DitroniX/IPEM-Plus-ESP32-C5-LoRa-LoRaWAN-IoT-Mains-Power-Energy-Monitor/Certification/ESP32-C5-WROOM-1 SRRC Certification.pdf

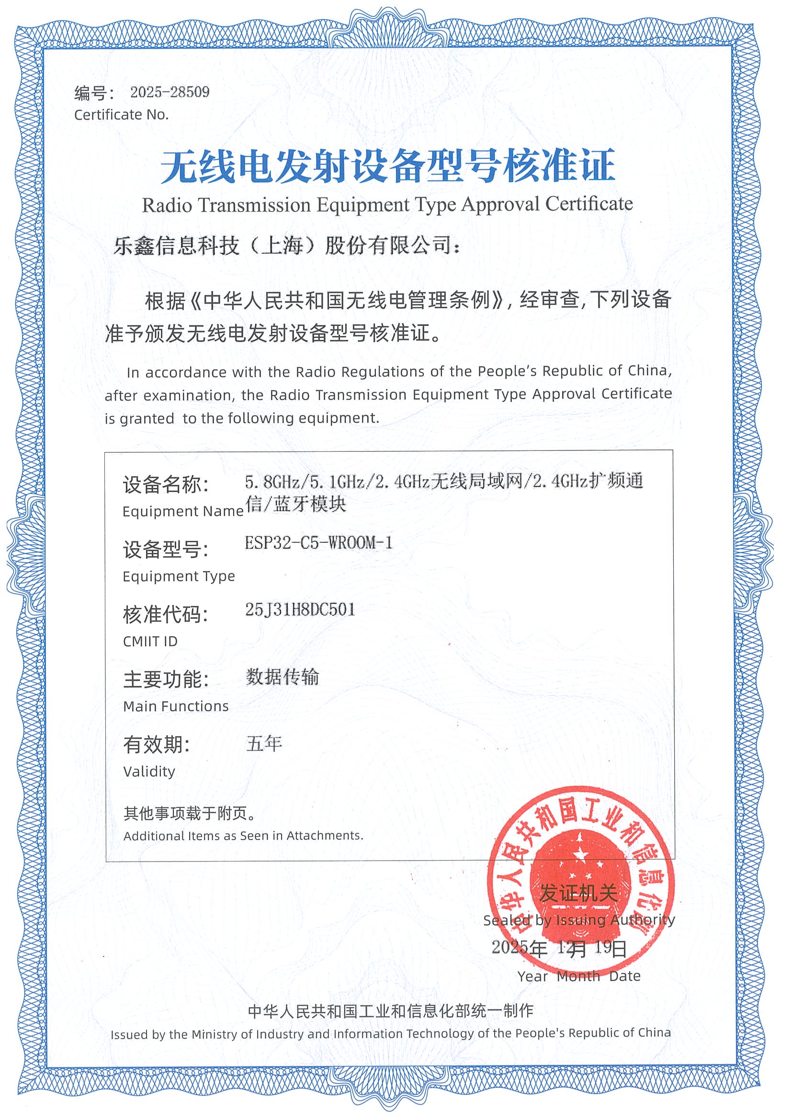
[picture p7: page 1]
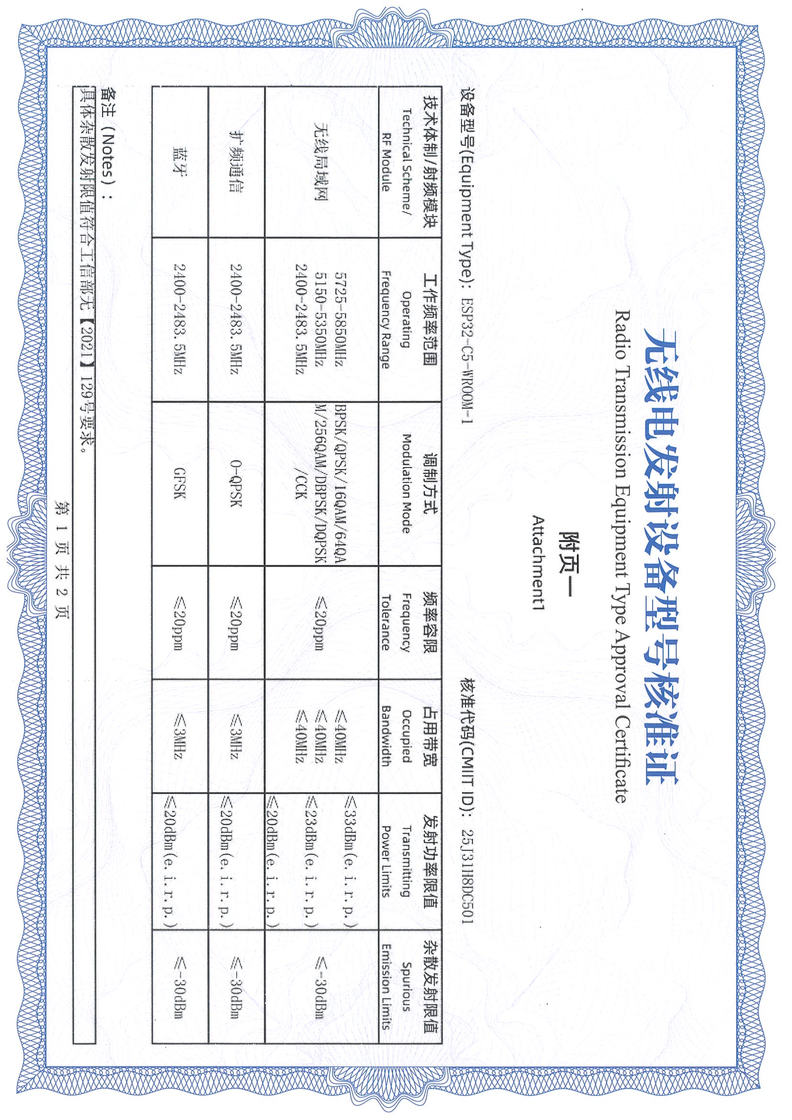
[picture p8: page 2]
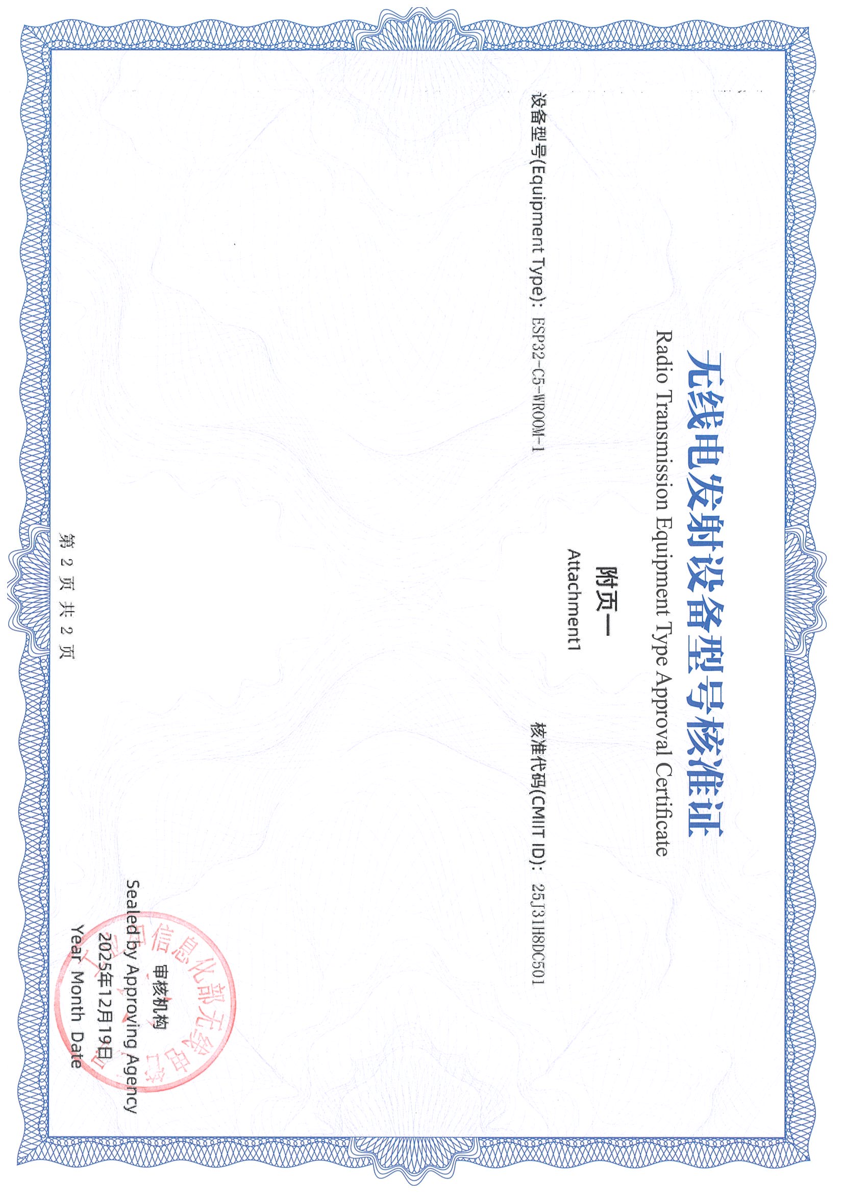
[picture p9: page 3]
