DitroniX/IPEM-Plus-ESP32-C5-LoRa-LoRaWAN-IoT-Mains-Power-Energy-Monitor/Datasheets and Information/Arduino ESP32C5 Dev Selection.png

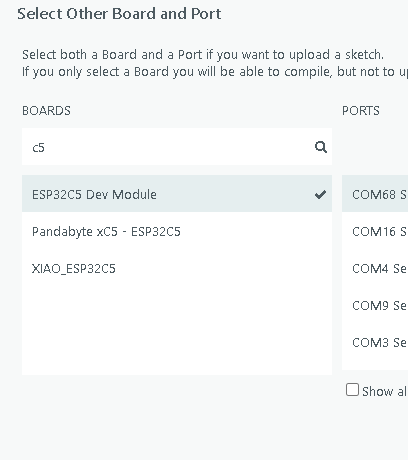
Datasheets and Information/Arduino ESP32C5 Dev Selection.png
