DitroniX/IPEM-Plus-ESP32-C5-LoRa-LoRaWAN-IoT-Mains-Power-Energy-Monitor/Datasheets and Information/Arduino IDE ESP32-C5 Board and Port.png

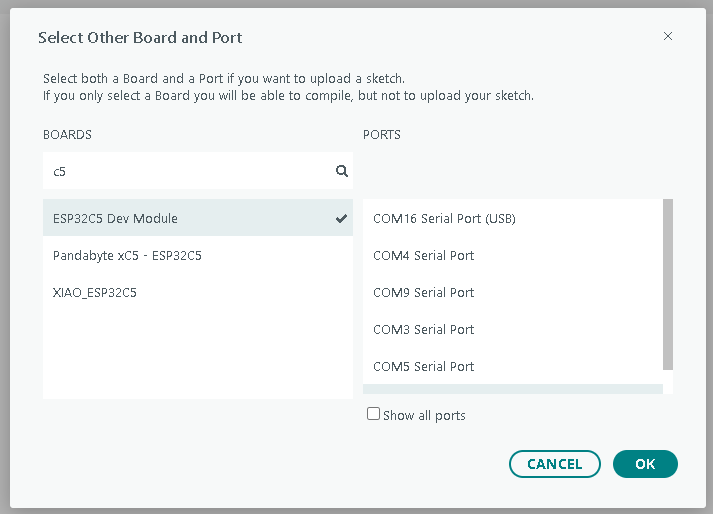
Datasheets and Information/Arduino IDE ESP32-C5 Board and Port.png
