DitroniX/IPEM-Plus-ESP32-C5-LoRa-LoRaWAN-IoT-Mains-Power-Energy-Monitor/Datasheets and Information/ATM90E36A Background.png

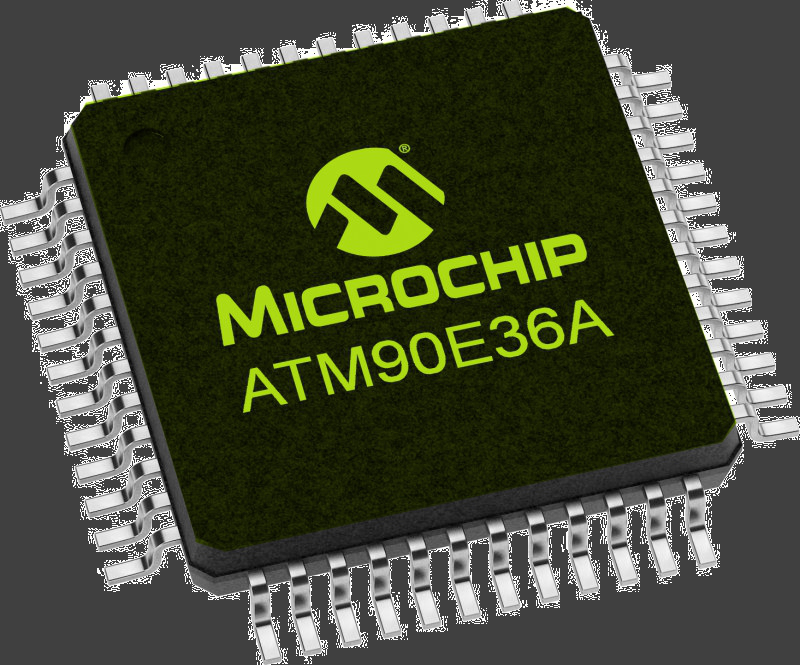
Datasheets and Information/ATM90E36A Background.png
