DitroniX/IPEM-Plus-ESP32-C5-LoRa-LoRaWAN-IoT-Mains-Power-Energy-Monitor/Datasheets and Information/ESP32-C5-Radio.jpg

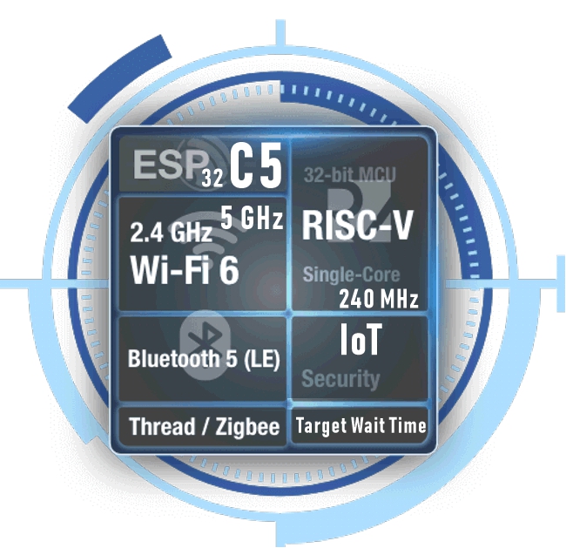
Datasheets and Information/ESP32-C5-Radio.jpg
