DitroniX/IPEM-Plus-ESP32-C5-LoRa-LoRaWAN-IoT-Mains-Power-Energy-Monitor/Datasheets and Information/IPEM Plus - AC - DC Power.png

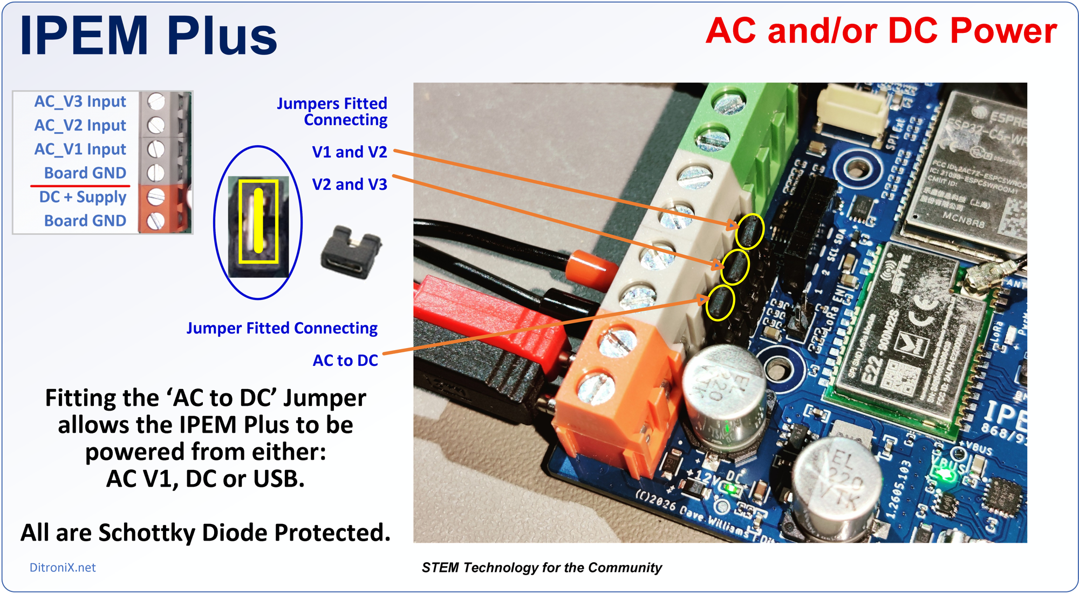
Datasheets and Information/IPEM Plus - AC - DC Power.png
