DitroniX/IPEM-Plus-ESP32-C5-LoRa-LoRaWAN-IoT-Mains-Power-Energy-Monitor/Datasheets and Information/IPEM Plus - Default Jumpers ATM90E36 Power Modes.png

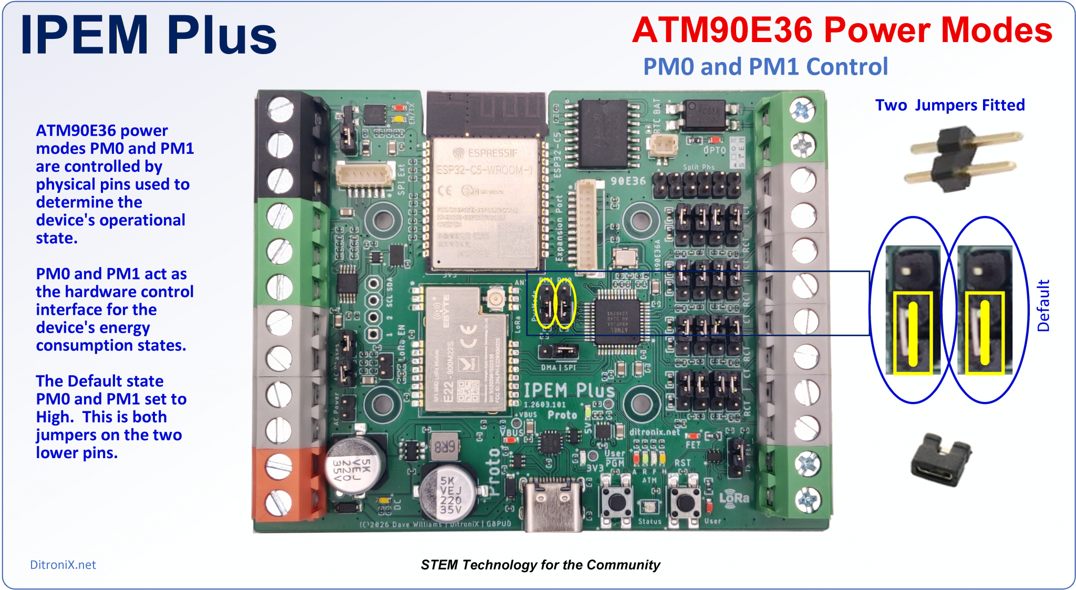
Datasheets and Information/IPEM Plus - Default Jumpers ATM90E36 Power Modes.png
