DitroniX/IPEM-Plus-ESP32-C5-LoRa-LoRaWAN-IoT-Mains-Power-Energy-Monitor/Datasheets and Information/IPEM Plus - Default Jumpers CT Current Clamps.png

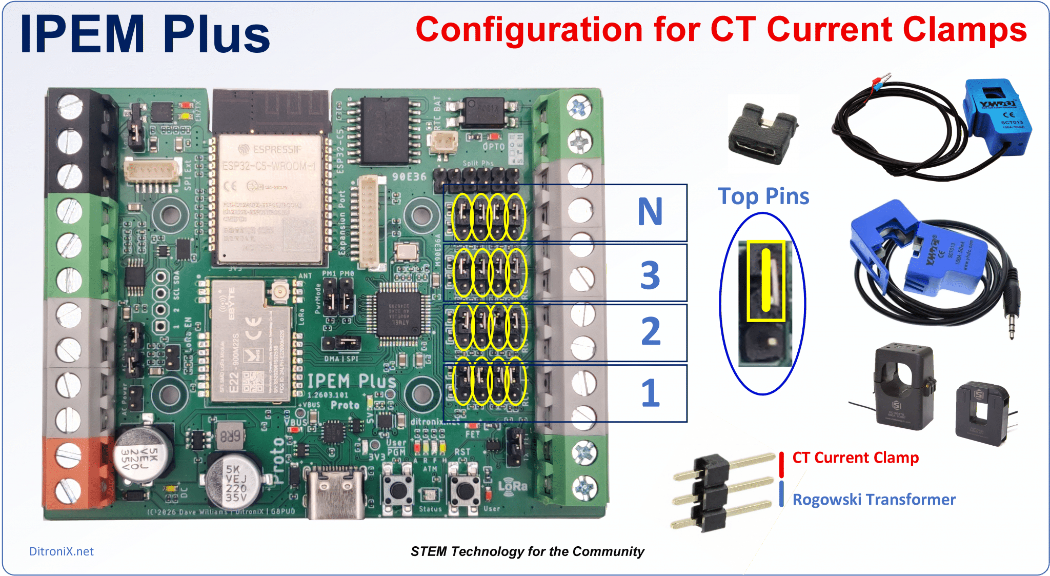
Datasheets and Information/IPEM Plus - Default Jumpers CT Current Clamps.png
