DitroniX/IPEM-Plus-ESP32-C5-LoRa-LoRaWAN-IoT-Mains-Power-Energy-Monitor/Datasheets and Information/IPEM Plus ESP32-C5 LoRa SX1262 ATM90E36.jpg

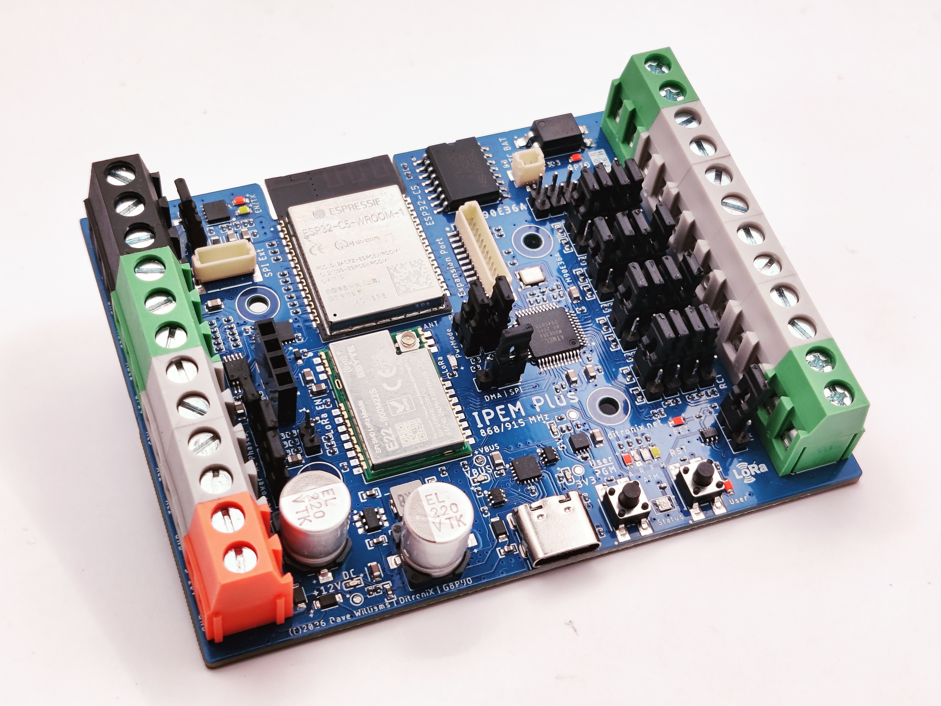
Datasheets and Information/IPEM Plus ESP32-C5 LoRa SX1262 ATM90E36.jpg
