DitroniX/IPEM-Plus-ESP32-C5-LoRa-LoRaWAN-IoT-Mains-Power-Energy-Monitor/Datasheets and Information/IPEM Plus ESP32-C5 SX1262 E22-900M22S LoRa 1.2606.104P Schematic pg2.png

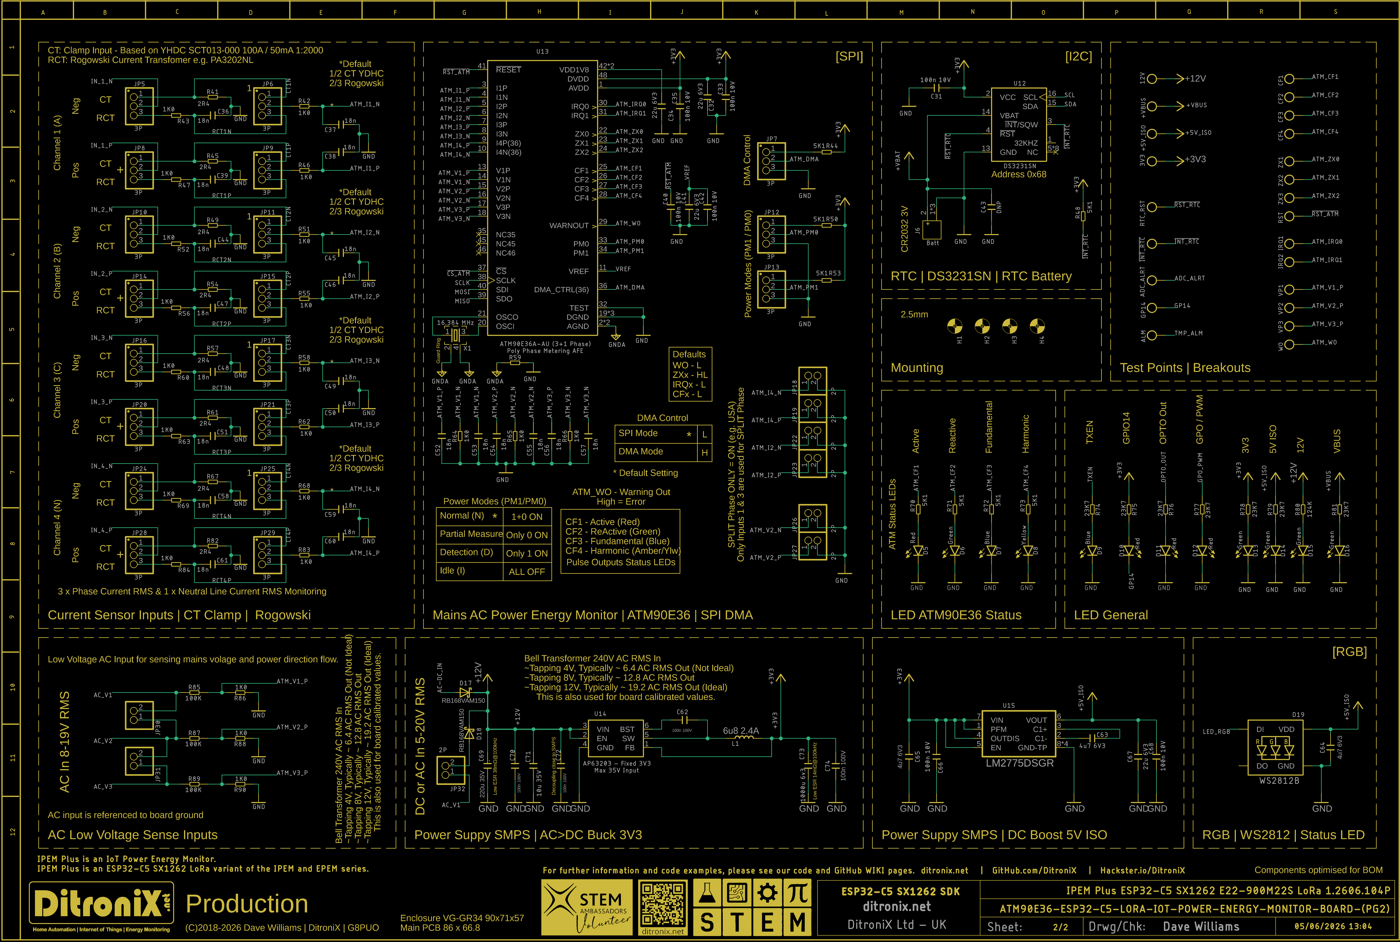
Datasheets and Information/IPEM Plus ESP32-C5 SX1262 E22-900M22S LoRa 1.2606.104P Schematic pg2.png
