DitroniX/IPEM-Plus-ESP32-C5-LoRa-LoRaWAN-IoT-Mains-Power-Energy-Monitor/Datasheets and Information/Non-intrusive load monitoring (NILM) Example.png

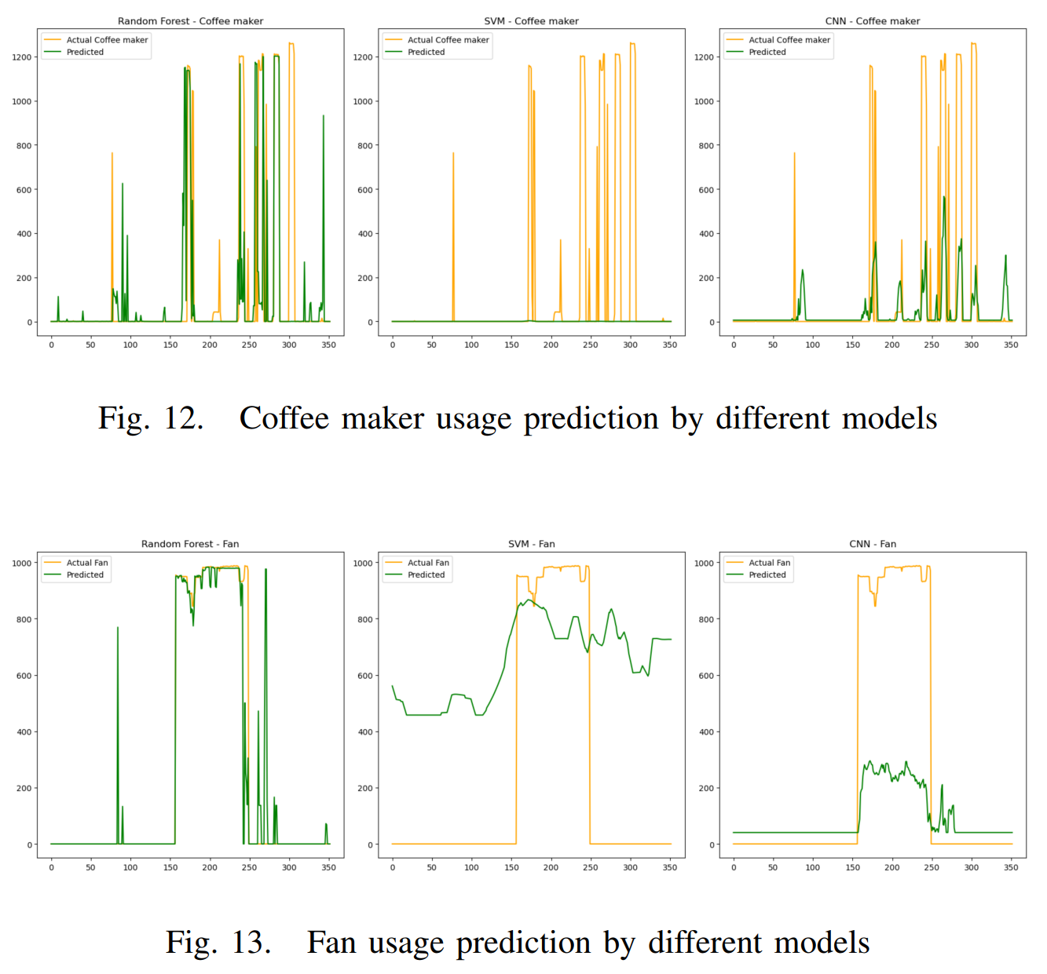
Datasheets and Information/Non-intrusive load monitoring (NILM) Example.png
