DitroniX/IPEM-Plus-ESP32-C5-LoRa-LoRaWAN-IoT-Mains-Power-Energy-Monitor/DitroniX.net-Lora-Topology-Overview.pdf

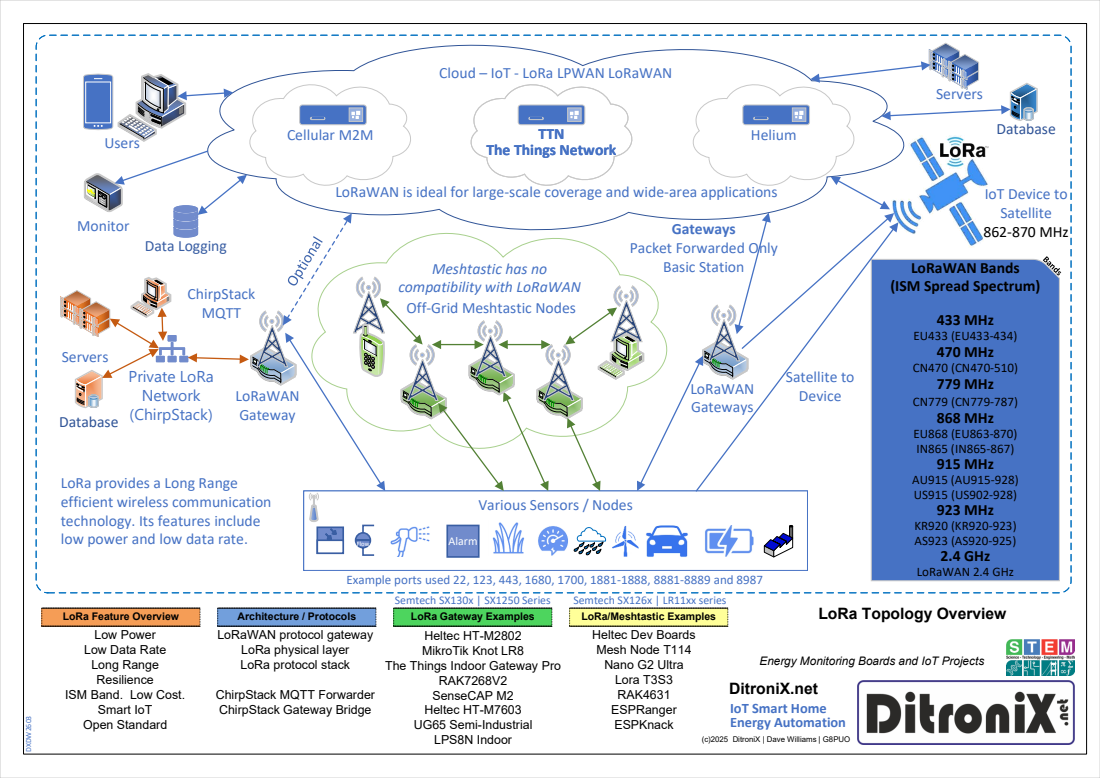
[picture p44: page 1]
LoRa Feature Overview; Architecture / Protocols; LoRa Gateway Examples; LoRa/Meshtastic Examples; 433 MHz EU433 (EU433-434) 470 MHz CN470 (CN470-510) 779 MHz CN779 (CN779-787) 868 MHz EU868 (EU863-870) IN865 (IN865-867) 915 MHz AU915 (AU915-928) US915 (US902-928) 923 MHz KR920 (KR920-923) AS923 (AS920-925) 2.4 GHz LoRaWAN 2.4 GHz; Heltec Dev Boards Mesh Node T114 Nano G2 Ultra Lora T3S3 RAK4631 ESPRanger ESPKnack; Heltec HT-M2802 MikroTik Knot LR8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

Cloud – IoT - LoRa LPWAN LoRaWAN

The Things Network

LoRaWAN is ideal for large-scale coverage and wide-area applications

IoT Device to
Satellite
862-870 MHz

Gateways
Packet Forwarded Only
Basic Station

Meshtastic has no
compatibility with LoRaWAN
Off-Grid Meshtastic Nodes

LoRaWAN Bands
(ISM Spread Spectrum)

LoRa provides a Long Range
efficient wireless communication
technology. Its features include
low power and low data rate.

Various Sensors / Nodes

Example ports used 22, 123, 443, 1680, 1700, 1881-1888, 8881-8889 and 8987

LoRa Topology Overview

Low Power
Low Data Rate
Long Range
Resilience
ISM Band. Low Cost.
Smart IoT
Open Standard

LoRaWAN protocol gateway
LoRa physical layer
LoRa protocol stack

The Things Indoor Gateway Pro

Energy Monitoring Boards and IoT Projects
DitroniX.net
IoT Smart Home
Energy Automation

ChirpStack MQTT Forwarder
ChirpStack Gateway Bridge

(c)2025 DitroniX | Dave Williams | G8PUO
