DitroniX/IPEM-Plus-ESP32-C5-LoRa-LoRaWAN-IoT-Mains-Power-Energy-Monitor/(commit log)

2026-02-23 Update README.md for improved clarity and updates
    Enhanced the README.md for clarity and added new SDK board information.
2026-02-23 Create IPEM Plus in DIN Enclosure (Accessories).png
2026-02-23 Update IPEM Plus in DIN Enclosure (Accessories).png
2026-03-16 ESP32-C5 Wireless Logo
2026-03-27 Create IPEM Plus - Current Monitoring.png
2026-03-27 Create IPEM Plus CT Clamp connected to Consumer Unit Tails.jpg
2026-03-29 Update IPEM Plus LoRa Wireless description
    Clarified the description of IPEM Plus LoRa Wireless to include the need for a suitable installation antenna.
2026-03-30 Update README with IPEM Plus usage and image
    Added a section on where IPEM Plus can be used and included an image for current monitors.
2026-04-09 Create Arduino IDE ESP32-C5 Board and Port.png
2026-04-09 Create Arduino ESP32C5 Dev Selection.png
2026-04-11 IPEM Plus ATM90E36 Registers
    [IPEM Plus ATM90E32 ATM90E36 Registers.xlsx]
2026-04-13 Create IPEM Plus - Default Jumpers FET EN.png
2026-04-21 Create AP63203WU-7 3v3 2A 32V Datasheet.pdf
2026-05-30 IPEM Plus - AC - DC Power
2026-06-14 Create IPEM Plus Pin Matrix.png
2026-06-14 IPEM Plus ESP32-C5 SX1262 E22-900M22S LoRa 1.2606.104P Schematic
2026-06-14 Update IPEM Plus Pin Matrix.png
2026-07-03 IPEM Plus ESP32-C5 LoRa SX1262 ATM90E36
2026-07-03 Add image to IPEM Plus description in README
    Added an image of the IPEM Plus board to the README.
